ArtemisFTW/Dum-E-Robotic-Arm-v0/CAD/servo-arm-horn-25t-aluminium-1.snapshot.1/SERVO ARM HORN 25T ALUMINIUM/SERVO ARM HORN WITH FASTENERS.SLDASM

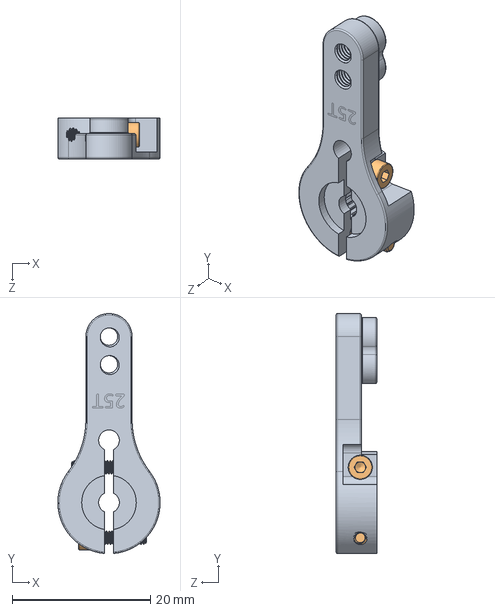
[picture p4: CAD file, 2026-11-02]
CAD/servo-arm-horn-25t-aluminium-1.snapshot.1/SERVO ARM HORN 25T ALUMINIUM/SERVO ARM HORN WITH FASTENERS.SLDASM
14.8 x 34.7 x 5.90 mm
SERVO ARM HORN 25T ALUMINIUM
M2 CAP HEAD SOCKET SCREW x 2
