ArtemisFTW/Dum-E-Robotic-Arm-v0/CAD/shoulder_servo_mount.STEP

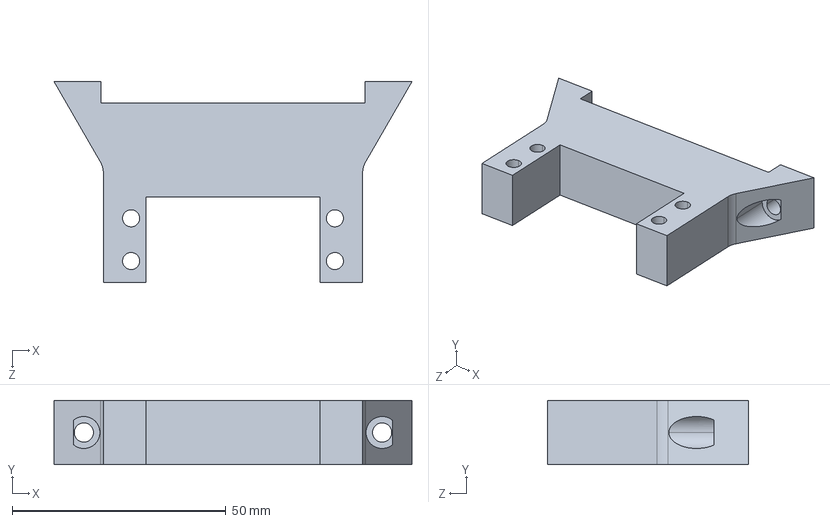
[picture p6: CAD file, 2026-11-02]
CAD/shoulder_servo_mount.STEP
83.8 x 15.0 x 47.0 mm
