ArtemisFTW/Dum-E-Robotic-Arm-v0/CAD/base_plate.STEP

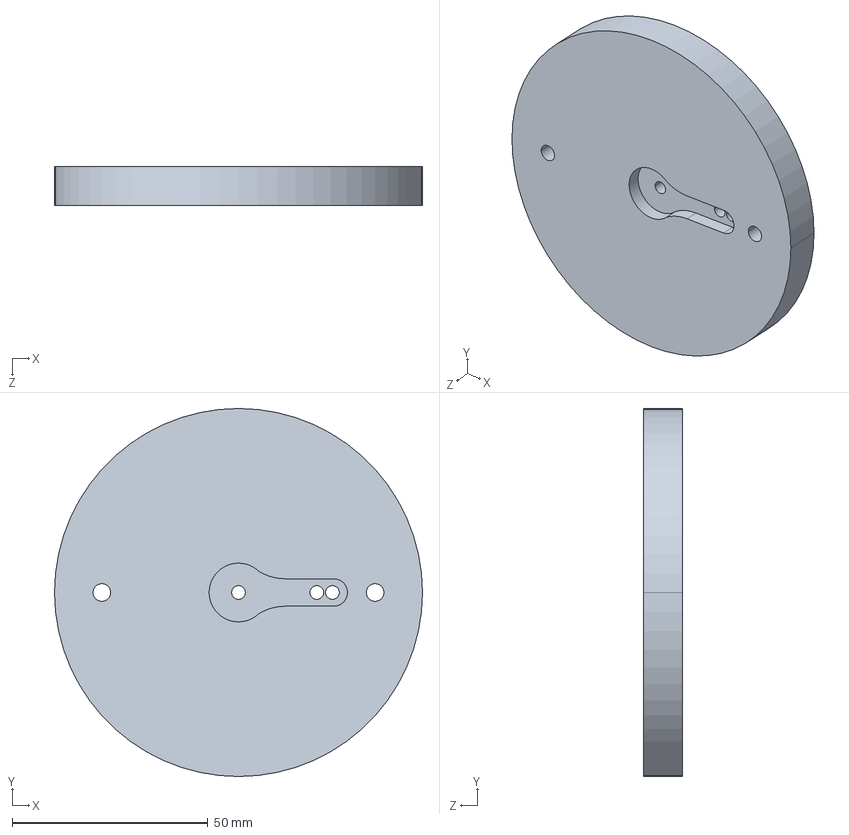
[picture p7: CAD file, 2026-11-02]
CAD/base_plate.STEP
94.0 x 94.0 x 10.0 mm
