ArtemisFTW/Dum-E-Robotic-Arm-v0/CAD/servo-arm-horn-25t-aluminium-1.snapshot.1/SERVO ARM HORN 25T ALUMINIUM/SERVO ARM HORN 25T ALUMINIUM.STEP

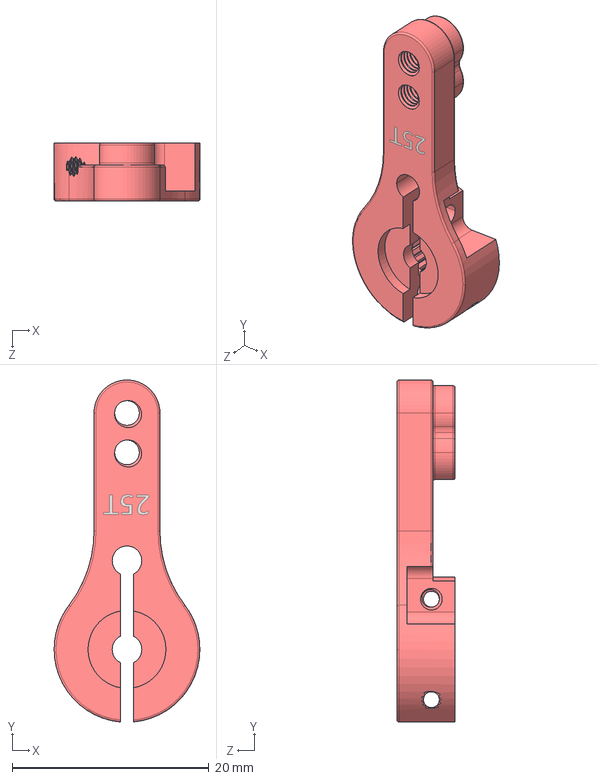
[picture p8: CAD file, 2026-11-02]
CAD/servo-arm-horn-25t-aluminium-1.snapshot.1/SERVO ARM HORN 25T ALUMINIUM/SERVO ARM HORN 25T ALUMINIUM.STEP
14.8 x 34.7 x 5.90 mm
