ArtemisFTW/Dum-E-Robotic-Arm-v0/CAD/base_bottom_new.STEP

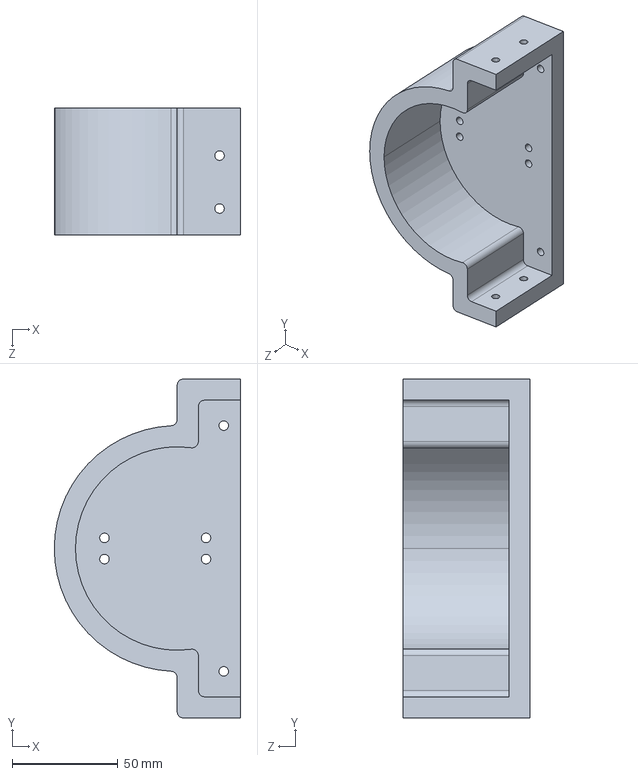
[picture p9: CAD file, 2026-11-02]
CAD/base_bottom_new.STEP
88.0 x 160.0 x 59.9 mm
