ArtemisFTW/Dum-E-Robotic-Arm-v0/CAD/servo_horn_fit_test2.STEP

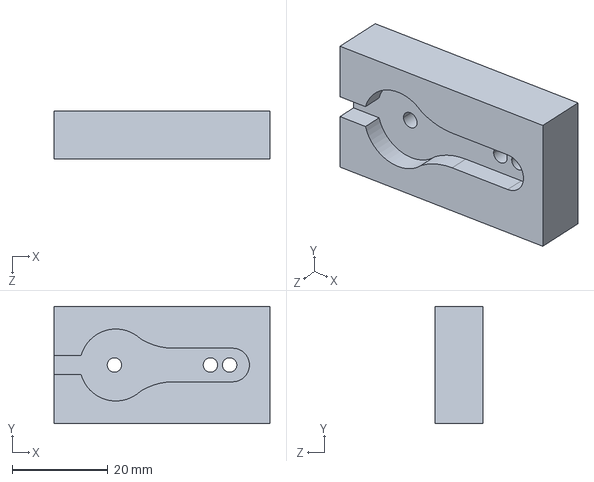
[picture p10: CAD file, 2026-11-02]
CAD/servo_horn_fit_test2.STEP
45.0 x 24.4 x 10.0 mm
