ArtemisFTW/Dum-E-Robotic-Arm-v0/CAD/base_lid.STEP

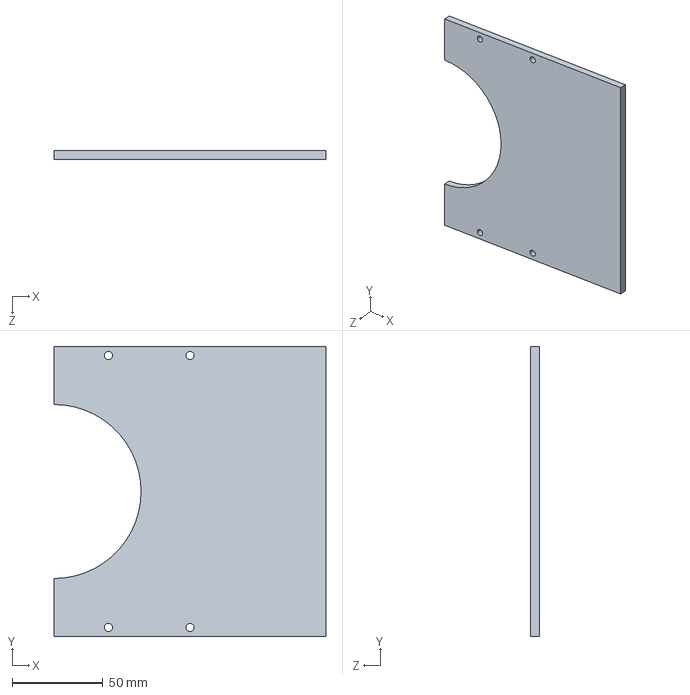
[picture p11: CAD file, 2026-11-02]
CAD/base_lid.STEP
150.0 x 160.0 x 5.00 mm
