ArtemisFTW/Dum-E-Robotic-Arm-v0/CAD/bas_back_cover.SLDPRT

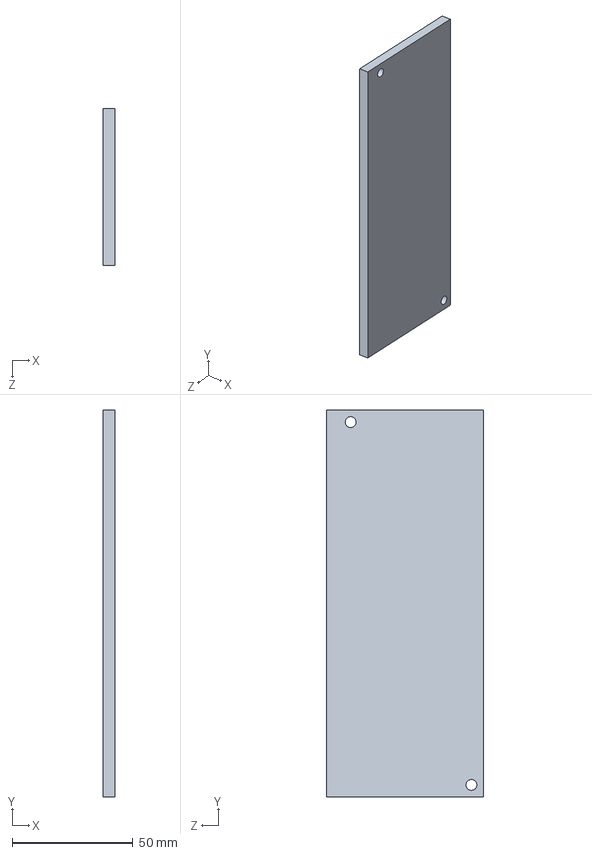
[picture p12: CAD file, 2026-11-02]
CAD/bas_back_cover.SLDPRT
5.00 x 160.0 x 64.9 mm
