ArtemisFTW/Dum-E-Robotic-Arm-v0/CAD/elbow.STEP

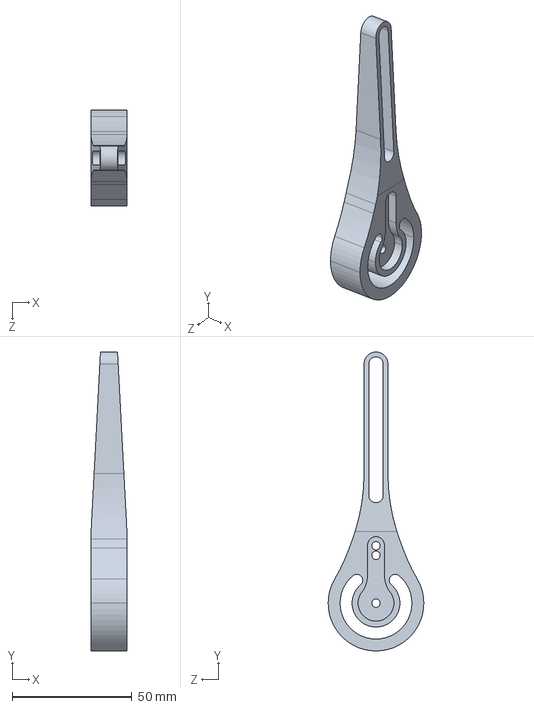
[picture p13: CAD file, 2026-11-02]
CAD/elbow.STEP
15.0 x 125.0 x 40.0 mm
