ArtemisFTW/Dum-E-Robotic-Arm-v0/CAD/servo20kgcm.SLDPRT

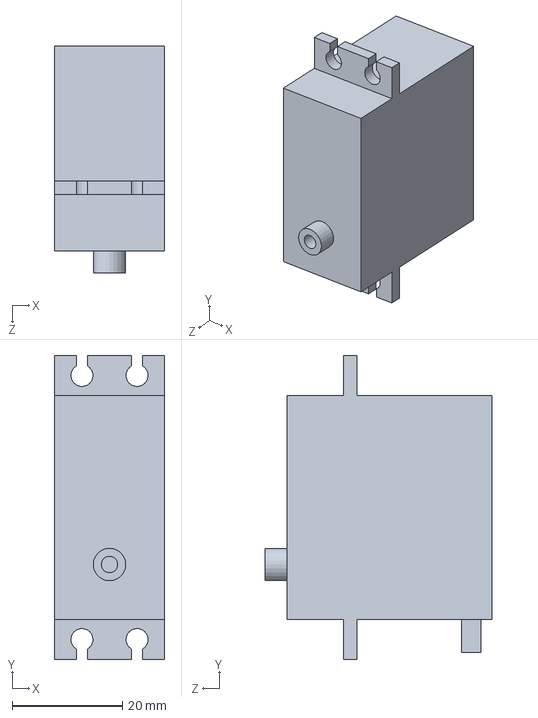
[picture p14: CAD file, 2026-11-02]
CAD/servo20kgcm.SLDPRT
20.0 x 55.2 x 41.2 mm
