ArtemisFTW/Dum-E-Robotic-Arm-v0/CAD/shoulder.STEP

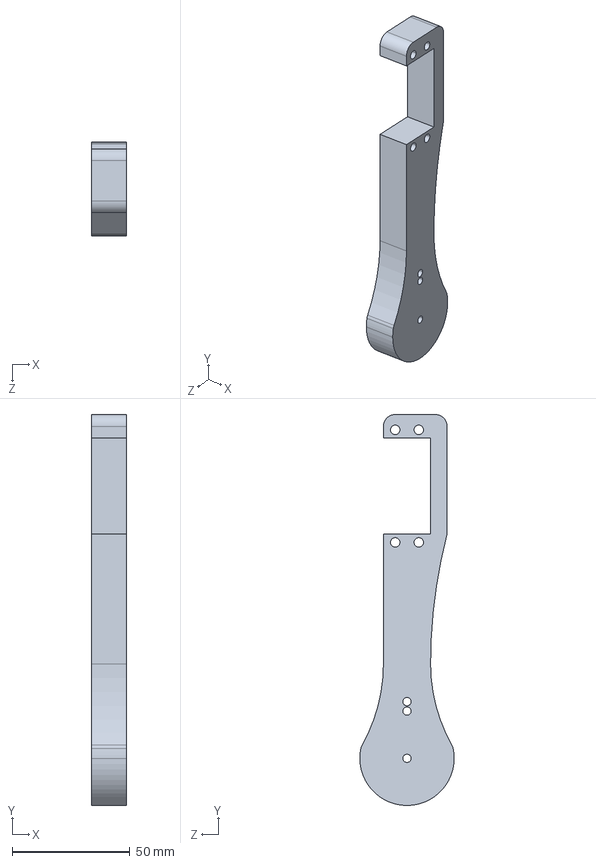
[picture p15: CAD file, 2026-11-02]
CAD/shoulder.STEP
15.0 x 165.7 x 40.0 mm
