ArtemisFTW/Dum-E-Robotic-Arm-v0/CAD/base_bottom.STEP

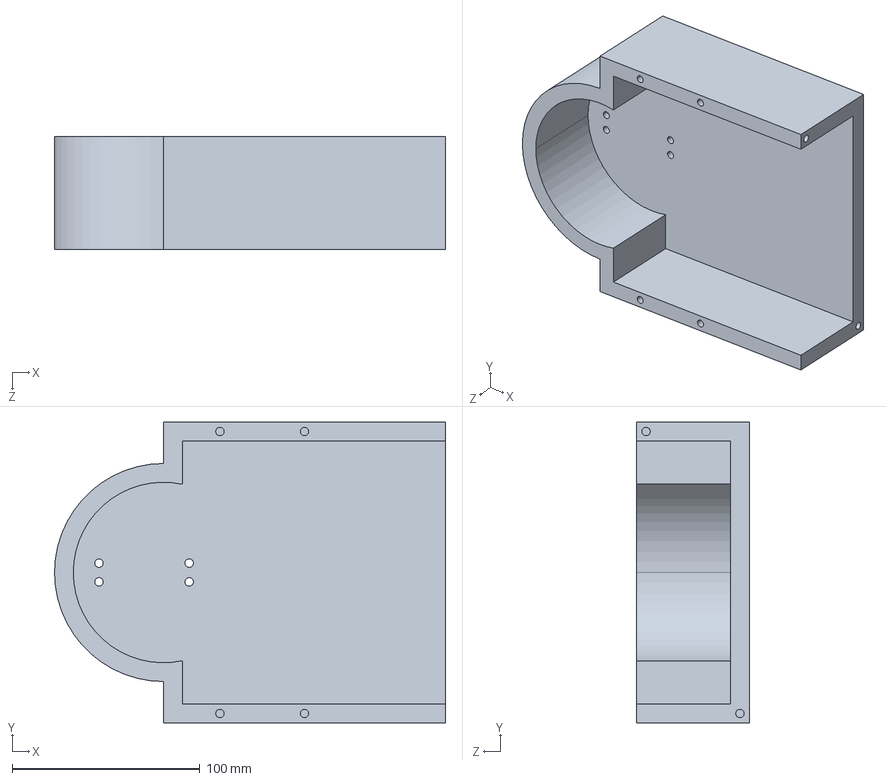
[picture p16: CAD file, 2026-11-02]
CAD/base_bottom.STEP
208.0 x 160.0 x 59.9 mm
