ArtemisFTW/Dum-E-Robotic-Arm-v0/CAD/servo_bracket.STEP

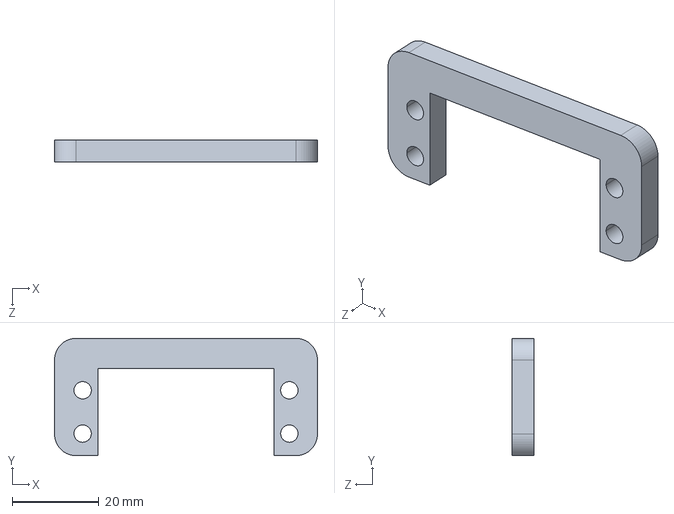
[picture p17: CAD file, 2026-11-02]
CAD/servo_bracket.STEP
60.7 x 27.1 x 5.00 mm
