ArtemisFTW/Dum-E-Robotic-Arm-v0/CAD/servo-arm-horn-25t-aluminium-1.snapshot.1/SERVO ARM HORN 25T ALUMINIUM/base_shoulder_elbow.SLDASM

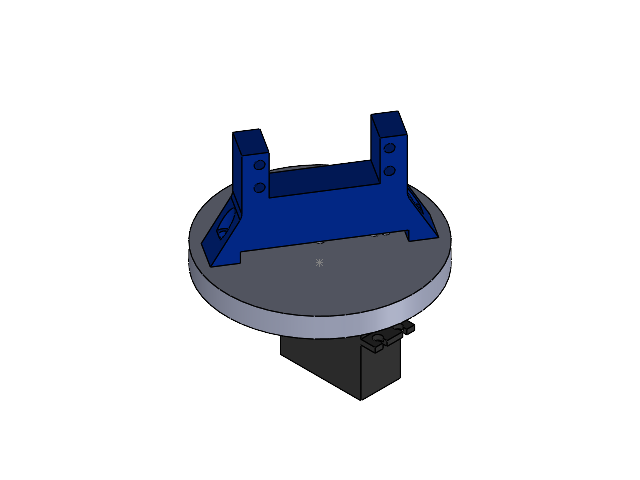
[picture p18: CAD file, 2026-11-02]
CAD/servo-arm-horn-25t-aluminium-1.snapshot.1/SERVO ARM HORN 25T ALUMINIUM/base_shoulder_elbow.SLDASM
servo20kgcm
SERVO ARM HORN 25T ALUMINIUM
base_plate
shoulder_servo_mount
