ArtemisFTW/Dum-E-Robotic-Arm-v0/CAD/elbow_plus_shoulder.SLDASM

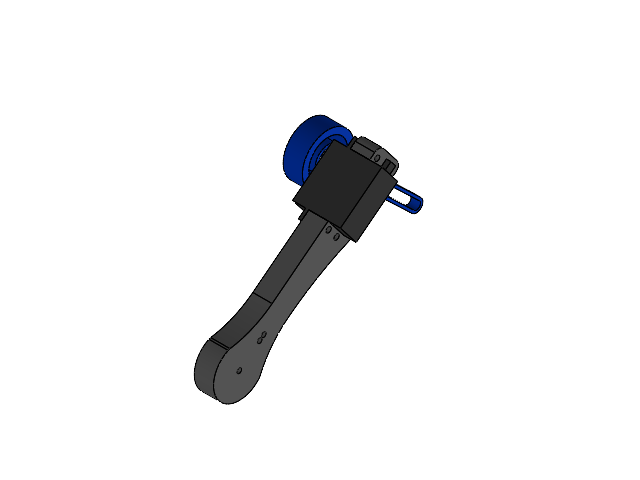
[picture p19: CAD file, 2026-11-02]
CAD/elbow_plus_shoulder.SLDASM
shoulder
SERVO ARM HORN 25T ALUMINIUM x 2
servo20kgcm
elbow
