ArtemisFTW/Dum-E-Robotic-Arm-v0/CAD/base_bottom_and_top.SLDASM

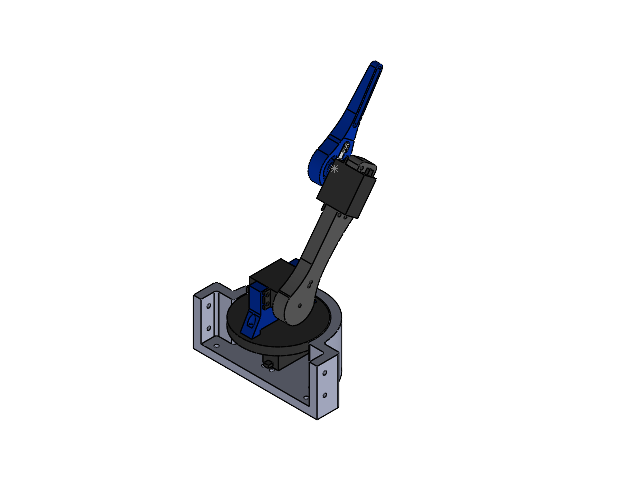
[picture p20: CAD file, 2026-11-02]
CAD/base_bottom_and_top.SLDASM
base_bottom
servo20kgcm x 3
SERVO ARM HORN 25T ALUMINIUM x 3
base_plate
shoulder_servo_mount
shoulder
elbow
