ArtemisFTW/Dum-E-Robotic-Arm-v0/CAD/3link_assembly.SLDASM

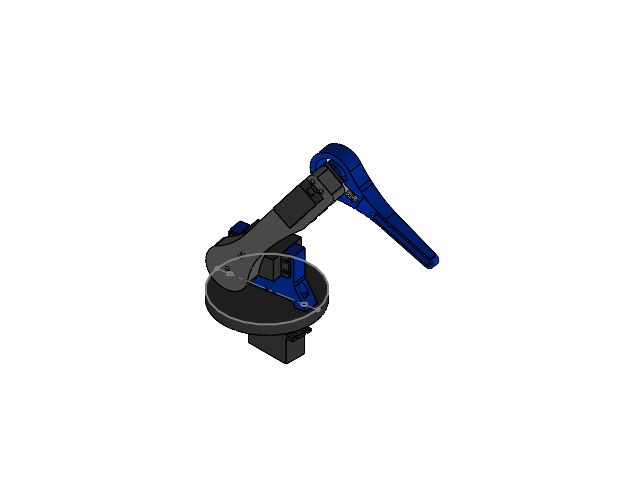
[picture p21: CAD file, 2026-11-02]
CAD/3link_assembly.SLDASM
servo20kgcm x 3
SERVO ARM HORN 25T ALUMINIUM x 3
base_plate
shoulder_servo_mount
shoulder
elbow
