ArtemisFTW/Dum-E-Robotic-Arm-v0/CAD/elbow_assembly.SLDASM

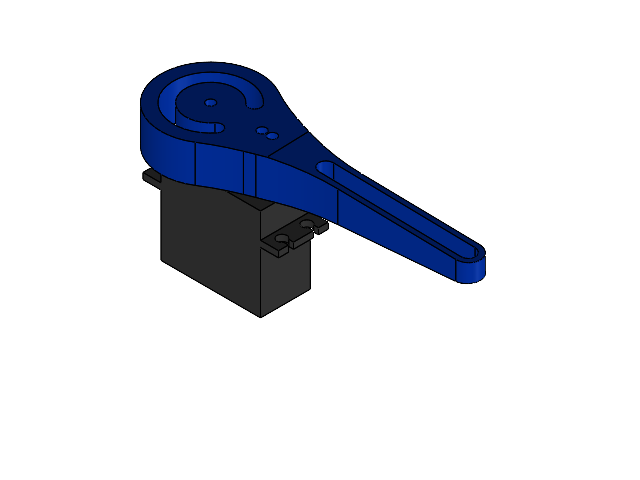
[picture p22: CAD file, 2026-11-02]
CAD/elbow_assembly.SLDASM
servo20kgcm
SERVO ARM HORN 25T ALUMINIUM
elbow
