ArtemisFTW/Dum-E-Robotic-Arm-v0/CAD/servo_with_arm.SLDASM

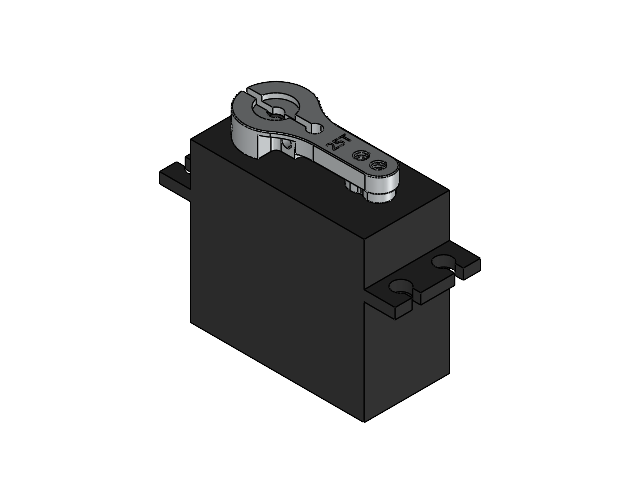
[picture p23: CAD file, 2026-11-02]
CAD/servo_with_arm.SLDASM
servo20kgcm
SERVO ARM HORN 25T ALUMINIUM
