ArtemisFTW/Dum-E-Robotic-Arm-v0/CAD/base_with_cover.SLDASM

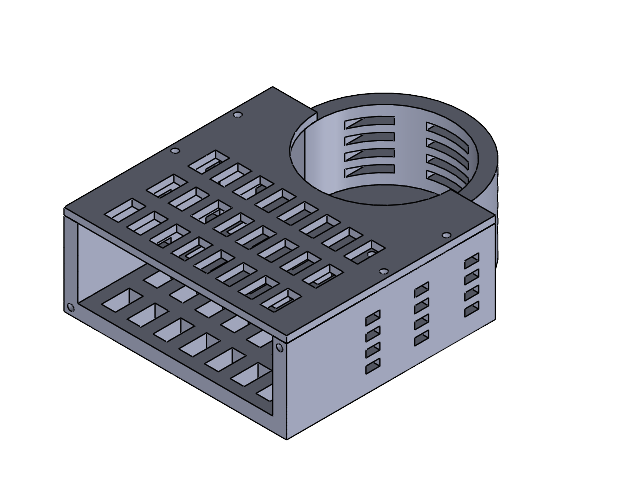
[picture p24: CAD file, 2026-11-02]
CAD/base_with_cover.SLDASM
base_bottom
base_lid
