ArtemisFTW/Dum-E-Robotic-Arm-v0/CAD/servo_with_bracket.SLDASM

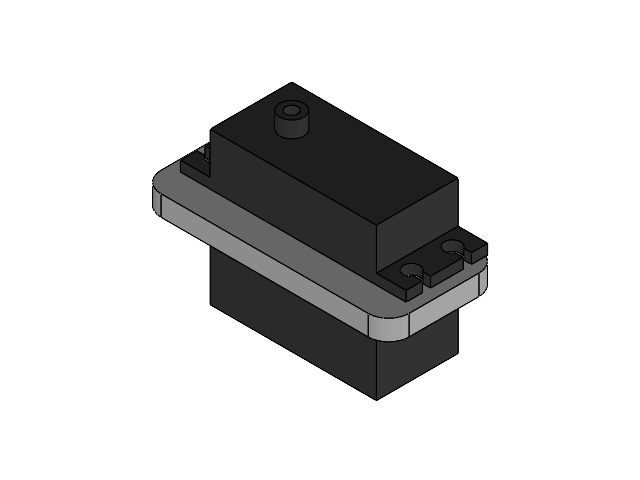
[picture p25: CAD file, 2026-11-02]
CAD/servo_with_bracket.SLDASM
servo20kgcm
servo_bracket
