ArtemisFTW/Dum-E-Robotic-Arm-v0/CAD/base_plate_plus_shoulder_mount.SLDASM

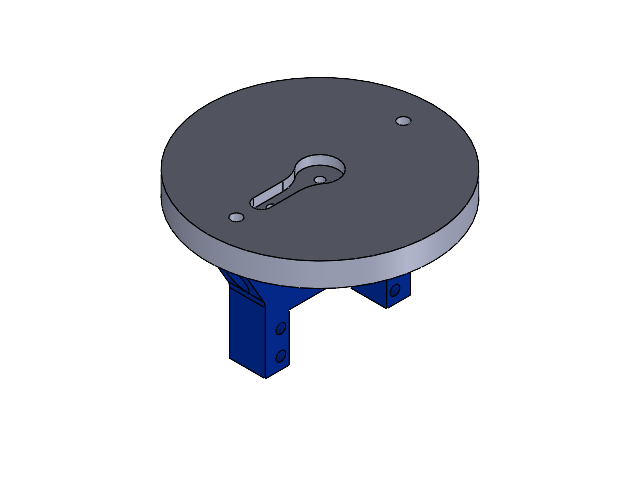
[picture p26: CAD file, 2026-11-02]
CAD/base_plate_plus_shoulder_mount.SLDASM
base_plate
shoulder_servo_mount
