ArtemisFTW/Dum-E-Robotic-Arm-v0/CAD/elbow_plus_horn.SLDASM

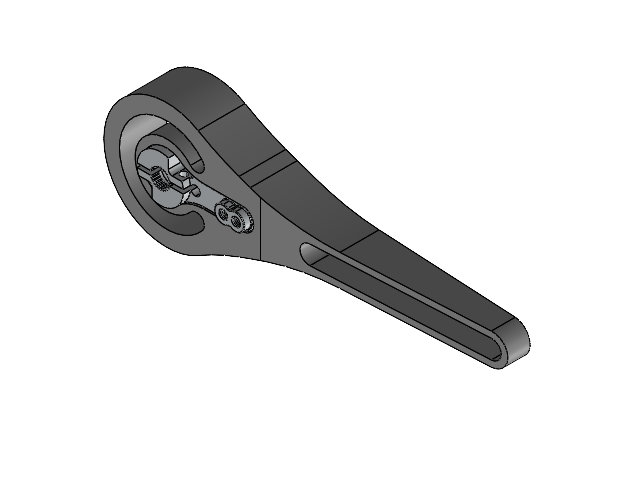
[picture p27: CAD file, 2026-11-02]
CAD/elbow_plus_horn.SLDASM
SERVO ARM HORN 25T ALUMINIUM
elbow
