ArtemisFTW/Dum-E-Robotic-Arm-v0/(list of files, cad)

Other CAD files:
CAD/servo_horn_outline.SLDPRT
CAD/base_bottom.3mf
CAD/base_bottom.SLDPRT
CAD/base_bottom_new.SLDPRT
CAD/base_lid.3mf
CAD/base_lid.SLDPRT
CAD/base_plate.3mf
CAD/base_plate.SLDPRT
CAD/elbow.3mf
CAD/elbow.SLDPRT
CAD/servo-arm-horn-25t-aluminium-1.snapshot.1/SERVO ARM HORN 25T ALUMINIUM/M2 CAP HEAD SOCKET SCREW.SLDPRT
CAD/servo-arm-horn-25t-aluminium-1.snapshot.1/SERVO ARM HORN 25T ALUMINIUM/M2 x 8 CAP HEAD SOCKET SCREW.IGS
CAD/servo-arm-horn-25t-aluminium-1.snapshot.1/SERVO ARM HORN 25T ALUMINIUM/M2 x 8 CAP HEAD SOCKET SCREW.STEP
CAD/servo-arm-horn-25t-aluminium-1.snapshot.1/SERVO ARM HORN 25T ALUMINIUM/SERVO ARM HORN 25T ALUMINIUM.IGS
CAD/servo-arm-horn-25t-aluminium-1.snapshot.1/SERVO ARM HORN 25T ALUMINIUM/SERVO ARM HORN 25T ALUMINIUM.SLDPRT
CAD/servo_bracket.3mf
CAD/servo_bracket.SLDPRT
CAD/servo_horn_fit_test.SLDPRT
CAD/servo_horn_fit_test.STL
CAD/shoulder.3mf
CAD/shoulder.SLDPRT
CAD/shoulder_servo_mount.3mf
CAD/shoulder_servo_mount.SLDPRT
