ArtemisFTW/Dum-E-Robotic-Arm-v0/Code/servo_test_f446re/servo_sweep_test.ioc

Mcu.UserName=STM32F446RETx
PA2.Signal=USART2_TX
PA3.Signal=USART2_RX
PA6.Signal=S_TIM3_CH1
