ArtemisFTW/Dum-E-Robotic-Arm-v0/Code/servo_test_f446re/Core/Inc/servo_console.h

#ifndef SERVO_CONSOLE_H
#define SERVO_CONSOLE_H

#include "stm32f4xx_hal.h"

void ServoConsole_Init(TIM_HandleTypeDef *timer, UART_HandleTypeDef *uart);
void ServoConsole_Poll(void);

/* Command estimates only; the servo provides no measured shaft feedback. */
extern volatile uint32_t servo_command_us;
extern volatile uint32_t servo_target_angle;
extern volatile uint32_t servo_sweep_count;

#endif
